ndhulipala1/comparch_synth/README.md

# Digital Synthesizer

Olin College Computer Architecture (ENGR3410) final project, Fall 2022.

Neel Dhulipala and Devlin Ih
