ndhulipala1/comparch_synth/main.xdc

# Button  0 is reset
# Button  1 changes waveform
# Pin     1 is channel 1
# Pin    48 is channel 2


set_property CONFIG_VOLTAGE 3.3 [current_design]
set_property CFGBVS VCCO [current_design]

## Clock signal 12 MHz
set_property -dict { PACKAGE_PIN L17   IOSTANDARD LVCMOS33 } [get_ports { clk }]; #IO_L12P_T1_MRCC_14 Sch=gclk
create_clock -add -name sys_clk_pin -period 83.33 -waveform {0 41.66} [get_ports {clk}];


## LEDs
set_property -dict { PACKAGE_PIN A17   IOSTANDARD LVCMOS33 } [get_ports { leds[0] }]; #IO_L12N_T1_MRCC_16 Sch=led[1]
set_property -dict { PACKAGE_PIN C16   IOSTANDARD LVCMOS33 } [get_ports { leds[1] }]; #IO_L13P_T2_MRCC_16 Sch=led[2]

# set_property -dict { PACKAGE_PIN B17   IOSTANDARD LVCMOS33 } [get_ports { rgb[2] }]; #IO_L14N_T2_SRCC_16 Sch=led0_b
# set_property -dict { PACKAGE_PIN B16   IOSTANDARD LVCMOS33 } [get_ports { rgb[1] }]; #IO_L13N_T2_MRCC_16 Sch=led0_g
# set_pro perty -dict { PACKAGE_PIN C17   IOSTANDARD LVCMOS33 } [get_ports { rgb[0] }]; #IO_L14P_T2_SRCC_16 Sch=led0_r

## Buttons
set_property -dict { PACKAGE_PIN A18   IOSTANDARD LVCMOS33 } [get_ports { rst }]; #IO_L19N_T3_VREF_16 Sch=btn[0]
set_property -dict { PACKAGE_PIN B18   IOSTANDARD LVCMOS33 } [get_ports { buttons[0] }]; #IO_L19P_T3_16 Sch=btn[1]


## Pmod Header JA
# Amp plugs right into this. Pin1 on the amp is Pin1 on the header
# 1: pwm_out
# 2: gain
# 3: Not connected
# 4: shutdown_b
# 5: GND
# 6: Power

set_property -dict { PACKAGE_PIN G17   IOSTANDARD LVCMOS33 } [get_ports { pwm_out }]; #IO_L5N_T0_D07_14 Sch=ja[1]
set_property -dict { PACKAGE_PIN G19   IOSTANDARD LVCMOS33 } [get_ports { gain }]; #IO_L4N_T0_D05_14 Sch=ja[2]
# set_property -dict { PACKAGE_PIN N18   IOSTANDARD LVCMOS33 } [get_ports { pmod[2] }]; #IO_L9P_T1_DQS_14 Sch=ja[3]
set_property -dict { PACKAGE_PIN L18   IOSTANDARD LVCMOS33 } [get_ports { shutdown_b }]; #IO_L8P_T1_D11_14 Sch=ja[4]


# set_property -dict { PACKAGE_PIN H17   IOSTANDARD LVCMOS33 } [get_ports { pmod[4] }]; #IO_L5P_T0_D06_14 Sch=ja[7]
# set_property -dict { PACKAGE_PIN H19   IOSTANDARD LVCMOS33 } [get_ports { pmod[5] }]; #IO_L4P_T0_D04_14 Sch=ja[8]
# set_property -dict { PACKAGE_PIN J19   IOSTANDARD LVCMOS33 } [get_ports { pmod[6] }]; #IO_L6N_T0_D08_VREF_14 Sch=ja[9]
# set_property -dict { PACKAGE_PIN K18   IOSTANDARD LVCMOS33 } [get_ports { pmod[7] }]; #IO_L8N_T1_D12_14 Sch=ja[10]


## GPIO Pins
## Pins 15 and 16 should remain commented if using them as analog inputs

set_property -dict { PACKAGE_PIN M3    IOSTANDARD LVCMOS33 } [get_ports { buttons[1] }]; #IO_L8N_T1_AD14N_35 Sch=pio[01]
set_property -dict { PACKAGE_PIN A16   IOSTANDARD LVCMOS33 } [get_ports { buttons[3] }]; #IO_L12P_T1_MRCC_16 Sch=pio[03]

set_property -dict { PACKAGE_PIN V8    IOSTANDARD LVCMOS33 } [get_ports { buttons[2] }]; #IO_L14N_T2_SRCC_34 Sch=pio[48]


#set_property -dict { PACKAGE_PIN L3    IOSTANDARD LVCMOS33 } [get_ports { buttons[3] }]; #IO_L8P_T1_AD14P_35 Sch=pio[02]

#set_property -dict { PACKAGE_PIN K3    IOSTANDARD LVCMOS33 } [get_ports { pio[04] }]; #IO_L7N_T1_AD6N_35 Sch=pio[04]
#set_property -dict { PACKAGE_PIN C15   IOSTANDARD LVCMOS33 } [get_ports { pio[05] }]; #IO_L11P_T1_SRCC_16 Sch=pio[05]
#set_property -dict { PACKAGE_PIN H1    IOSTANDARD LVCMOS33 } [get_ports { pio[06] }]; #IO_L3P_T0_DQS_AD5P_35 Sch=pio[06]
#set_property -dict { PACKAGE_PIN A15   IOSTANDARD LVCMOS33 } [get_ports { pio[07] }]; #IO_L6N_T0_VREF_16 Sch=pio[07]
#set_property -dict { PACKAGE_PIN B15   IOSTANDARD LVCMOS33 } [get_ports { pio[08] }]; #IO_L11N_T1_SRCC_16 Sch=pio[08]
#set_property -dict { PACKAGE_PIN A14   IOSTANDARD LVCMOS33 } [get_ports { pio[09] }]; #IO_L6P_T0_16 Sch=pio[09]
#set_property -dict { PACKAGE_PIN J3    IOSTANDARD LVCMOS33 } [get_ports { pio[10] }]; #IO_L7P_T1_AD6P_35 Sch=pio[10]
#set_property -dict { PACKAGE_PIN J1    IOSTANDARD LVCMOS33 } [get_ports { pio[11] }]; #IO_L3N_T0_DQS_AD5N_35 Sch=pio[11]
#set_property -dict { PACKAGE_PIN K2    IOSTANDARD LVCMOS33 } [get_ports { pio[12] }]; #IO_L5P_T0_AD13P_35 Sch=pio[12]
#set_property -dict { PACKAGE_PIN L1    IOSTANDARD LVCMOS33 } [get_ports { pio[13] }]; #IO_L6N_T0_VREF_35 Sch=pio[13]
#set_property -dict { PACKAGE_PIN L2    IOSTANDARD LVCMOS33 } [get_ports { pio[14] }]; #IO_L5N_T0_AD13N_35 Sch=pio[14]
#set_property -dict { PACKAGE_PIN M1    IOSTANDARD LVCMOS33 } [get_ports { pio[17] }]; #IO_L9N_T1_DQS_AD7N_35 Sch=pio[17]
#set_property -dict { PACKAGE_PIN N3    IOSTANDARD LVCMOS33 } [get_ports { pio[18] }]; #IO_L12P_T1_MRCC_35 Sch=pio[18]
#set_property -dict { PACKAGE_PIN P3    IOSTANDARD LVCMOS33 } [get_ports { pio[19] }]; #IO_L12N_T1_MRCC_35 Sch=pio[19]
#set_property -dict { PACKAGE_PIN M2    IOSTANDARD LVCMOS33 } [get_ports { pio[20] }]; #IO_L9P_T1_DQS_AD7P_35 Sch=pio[20]
#set_property -dict { PACKAGE_PIN N1    IOSTANDARD LVCMOS33 } [get_ports { pio[21] }]; #IO_L10N_T1_AD15N_35 Sch=pio[21]
#set_property -dict { PACKAGE_PIN N2    IOSTANDARD LVCMOS33 } [get_ports { pio[22] }]; #IO_L10P_T1_AD15P_35 Sch=pio[22]
#set_property -dict { PACKAGE_PIN P1    IOSTANDARD LVCMOS33 } [get_ports { pio[23] }]; #IO_L19N_T3_VREF_35 Sch=pio[23]
#set_property -dict { PACKAGE_PIN R3    IOSTANDARD LVCMOS33 } [get_ports { pio[26] }]; #IO_L2P_T0_34 Sch=pio[26]
#set_property -dict { PACKAGE_PIN T3    IOSTANDARD LVCMOS33 } [get_ports { pio[27] }]; #IO_L2N_T0_34 Sch=pio[27]
#set_property -dict { PACKAGE_PIN R2    IOSTANDARD LVCMOS33 } [get_ports { pio[28] }]; #IO_L1P_T0_34 Sch=pio[28]
#set_property -dict { PACKAGE_PIN T1    IOSTANDARD LVCMOS33 } [get_ports { pio[29] }]; #IO_L3P_T0_DQS_34 Sch=pio[29]
#set_property -dict { PACKAGE_PIN T2    IOSTANDARD LVCMOS33 } [get_ports { pio[30] }]; #IO_L1N_T0_34 Sch=pio[30]
#set_property -dict { PACKAGE_PIN U1    IOSTANDARD LVCMOS33 } [get_ports { pio[31] }]; #IO_L3N_T0_DQS_34 Sch=pio[31]
#set_property -dict { PACKAGE_PIN W2    IOSTANDARD LVCMOS33 } [get_ports { pio[32] }]; #IO_L5N_T0_34 Sch=pio[32]
#set_property -dict { PACKAGE_PIN V2    IOSTANDARD LVCMOS33 } [get_ports { pio[33] }]; #IO_L5P_T0_34 Sch=pio[33]
#set_property -dict { PACKAGE_PIN W3    IOSTANDARD LVCMOS33 } [get_ports { pio[34] }]; #IO_L6N_T0_VREF_34 Sch=pio[34]
#set_property -dict { PACKAGE_PIN V3    IOSTANDARD LVCMOS33 } [get_ports { pio[35] }]; #IO_L6P_T0_34 Sch=pio[35]
#set_property -dict { PACKAGE_PIN W5    IOSTANDARD LVCMOS33 } [get_ports { pio[36] }]; #IO_L12P_T1_MRCC_34 Sch=pio[36]
#set_property -dict { PACKAGE_PIN V4    IOSTANDARD LVCMOS33 } [get_ports { pio[37] }]; #IO_L11N_T1_SRCC_34 Sch=pio[37]
#set_property -dict { PACKAGE_PIN U4    IOSTANDARD LVCMOS33 } [get_ports { pio[38] }]; #IO_L11P_T1_SRCC_34 Sch=pio[38]
#set_property -dict { PACKAGE_PIN V5    IOSTANDARD LVCMOS33 } [get_ports { pio[39] }]; #IO_L16N_T2_34 Sch=pio[39]
#set_property -dict { PACKAGE_PIN W4    IOSTANDARD LVCMOS33 } [get_ports { pio[40] }]; #IO_L12N_T1_MRCC_34 Sch=pio[40]
#set_property -dict { PACKAGE_PIN U5    IOSTANDARD LVCMOS33 } [get_ports { pio[41] }]; #IO_L16P_T2_34 Sch=pio[41]
#set_property -dict { PACKAGE_PIN U2    IOSTANDARD LVCMOS33 } [get_ports { pio[42] }]; #IO_L9N_T1_DQS_34 Sch=pio[42]
#set_property -dict { PACKAGE_PIN W6    IOSTANDARD LVCMOS33 } [get_ports { pio[43] }]; #IO_L13N_T2_MRCC_34 Sch=pio[43]
#set_property -dict { PACKAGE_PIN U3    IOSTANDARD LVCMOS33 } [get_ports { pio[44] }]; #IO_L9P_T1_DQS_34 Sch=pio[44]
#set_property -dict { PACKAGE_PIN U7    IOSTANDARD LVCMOS33 } [get_ports { pio[45] }]; #IO_L19P_T3_34 Sch=pio[45]
#set_property -dict { PACKAGE_PIN W7    IOSTANDARD LVCMOS33 } [get_ports { pio[46] }]; #IO_L13P_T2_MRCC_34 Sch=pio[46]
#set_property -dict { PACKAGE_PIN U8    IOSTANDARD LVCMOS33 } [get_ports { pio[47] }]; #IO_L14P_T2_SRCC_34 Sch=pio[47]
#set_property -dict { PACKAGE_PIN V8    IOSTANDARD LVCMOS33 } [get_ports { pio[48] }]; #IO_L14N_T2_SRCC_34 Sch=pio[48]
