ndhulipala1/comparch_synth/hdl/sine_wave_generator.sv

/*
 Takes in main period signal from channel and outputs a sine wave from it.
 */
module sine_wave_generator(/*AUTOARG*/
                           // Outputs
                           sine,
                           // Inputs
                           period
                           );
   input  wire  [ 7:0] period;
   output logic [10:0] sine;

   // Brute force generated with Python
   // See sine_wave.py in this folder

   always_comb begin
      case(period)
        8'b00000000 : sine = 0;
        8'b00000001 : sine = 0;
        8'b00000010 : sine = 1;
        8'b00000011 : sine = 2;
        8'b00000100 : sine = 4;
        8'b00000101 : sine = 7;
        8'b00000110 : sine = 11;
        8'b00000111 : sine = 15;
        8'b00001000 : sine = 19;
        8'b00001001 : sine = 24;
        8'b00001010 : sine = 30;
        8'b00001011 : sine = 37;
        8'b00001100 : sine = 44;
        8'b00001101 : sine = 51;
        8'b00001110 : sine = 59;
        8'b00001111 : sine = 68;
        8'b00010000 : sine = 77;
        8'b00010001 : sine = 87;
        8'b00010010 : sine = 98;
        8'b00010011 : sine = 109;
        8'b00010100 : sine = 120;
        8'b00010101 : sine = 132;
        8'b00010110 : sine = 145;
        8'b00010111 : sine = 158;
        8'b00011000 : sine = 172;
        8'b00011001 : sine = 186;
        8'b00011010 : sine = 201;
        8'b00011011 : sine = 216;
        8'b00011100 : sine = 232;
        8'b00011101 : sine = 248;
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
        8'b11101101 : sine = 109;
        8'b11101110 : sine = 98;
        8'b11101111 : sine = 87;
        8'b11110000 : sine = 77;
        8'b11110001 : sine = 68;
        8'b11110010 : sine = 59;
        8'b11110011 : sine = 51;
        8'b11110100 : sine = 44;
        8'b11110101 : sine = 37;
        8'b11110110 : sine = 30;
        8'b11110111 : sine = 24;
        8'b11111000 : sine = 19;
        8'b11111001 : sine = 15;
        8'b11111010 : sine = 11;
        8'b11111011 : sine = 7;
        8'b11111100 : sine = 4;
        8'b11111101 : sine = 2;
        8'b11111110 : sine = 1;
        8'b11111111 : sine = 0;
      endcase
   end
endmodule
