ndhulipala1/comparch_synth/hdl/i2c_types.sv

`ifndef I2C_TYPES_H
`define I2C_TYPES_H

// Based on the i2c Specification
typedef enum logic {
  WRITE_12BIT_REGISTER = 0, READ_12BIT = 1
} i2c_transaction_t;

// Main FSM logic
typedef enum logic [3:0] {
  S_IDLE = 0,
  S_START = 1,
  S_ADDR = 2,
  S_ACK_ADDR = 3, 
  S_WR_DATA = 4, 
  S_ACK_WR = 5,
  S_RD_DATA = 6,
  S_ACK_RD = 7,
  S_STOP = 8, 
  S_ERROR
} i2c_state_t;

`endif // I2C_TYPES_H
