ndhulipala1/comparch_synth/(commit log)

2022-12-04 Merge clock-divider branch into main
    Squashed commit of the following:
    commit 2529bd592c907dfc32f85b6a4b413eff5f214df9
    Author: Devlin Ih <dih@olin.edu>
    Date: Sun Dec 4 15:11:41 2022 -0500
    Fix clock divider and find its equation
    commit b86c258d4cf15d2924e158b6536c91f1c1958d4e
    Author: Devlin Ih <dih@olin.edu>
    Date: Sun Dec 4 14:55:27 2022 -0500
    Tweak to better show clock and divided clock
    commit d97ce004959fa5146ef24bf9043133c1aa275f41
    Author: Devlin Ih <dih@olin.edu>
    Date: Sun Dec 4 14:54:42 2022 -0500
    Add gtkwave config for clock divider
    [clock_divider.sv, test_clock_divider.sv]
2022-12-05 Merge waveform modules into main branch.
    Implements channel module with 4 different waveforms to pick from.
    commit a64d412a619d7f5dfdb22ad09f9b679a8fc58070
    Date: Sun Dec 4 20:31:59 2022 -0500
    Fix minor bug in the testbench
    commit 55949e1ff0866f6d8b344dfd8fc68f95c05d97d9
    Date: Sun Dec 4 20:24:48 2022 -0500
    Fix issue with square wave generator where amplitude was 11, not -1.
    commit 039b028973f5d305eb81fb4a932be8080eb10041
    Date: Sun Dec 4 20:24:39 2022 -0500
    Modify issues found with test bench
    commit dab6240aa9de8c384f767ef69878e1e3b4d67e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
    [channel.sv, saw_wave_generator.sv, sine_wave.py, sine_wave_generator.sv, sq_wave_generator.sv, test_channel.sv, test_saw_wave_generator.sv, test_sine_wave_generator.sv]
2022-12-10 Remove second reset signal from channel module
    [channel.sv, test_channel.sv]
2022-12-10 Improve improved reset logic and update gtkwave conf
    [channel.sv, test_channel.sv]
2022-12-10 Further improve reset logic
    Keeps divide set to 0 (fastest divided clock possible) until both `rst_div` and
    `rst_div_reset` signal have gone low.
    [channel.sv]
2022-12-10 Slightly improve PWM performance
    No longer has spikes when modulated value is zero
    [audio_pwm_generator.sv]
2022-12-11 Make ready for synthesis and physical circuit
2022-12-11 Cleanup whitespace and correct a few signal names.
    [main.sv, main.xdc]
2022-12-13 Reformatting and fixed some variable names
    [main.sv]
2022-12-13 Add LEDs for debugging
    They attach to debounced buttons
2022-12-15 Refactor channel to use monostable on the divided clock
    Eliminates need to have state machine to reset logic
    [channel.sv, test_channel.sv]
2022-12-15 Finish documentation of MVP. - Remove debouncer from get_waveform, since debouncer already applied in main - Add image directory with images of schematics
2022-12-16 Fix test bench referring to saw by its old value of 3 instead of 2
    [channel.sv, test_channel.sv]
2022-12-16 Change default to 12 for pitch bit width
2022-12-17 Note: DO NOT USE PIN 2 on the FPGA
2022-12-17 Implement demo song assembler
2022-12-17 Fix bug where non-existent memory was read
    [demo_decoder.sv]
2022-12-18 Fix issue where garbage memory was loaded for 1 subdivision
    [demo_decoder.sv]
